carebare47/BalanceBotV2/v2/Balance-bot v2p1.stl

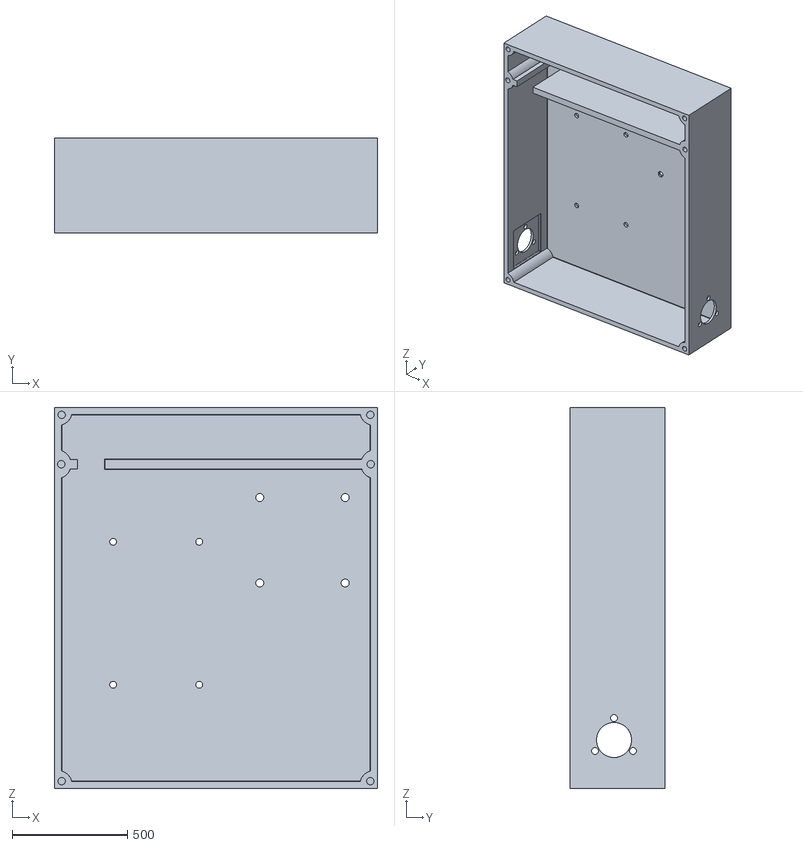
[picture p16: CAD file, 2018-06-24]
v2/Balance-bot v2p1.stl
1400.0 x 410.0 x 1650.0
