carebare47/BalanceBotV2/v2/batteryCasestl.stl

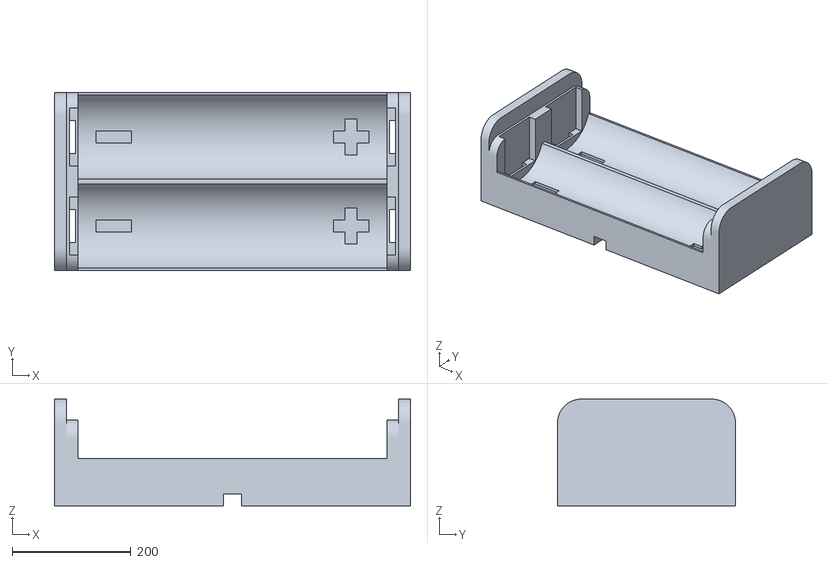
[picture p17: CAD file, 2018-06-24]
v2/batteryCasestl.stl
600.0 x 300.0 x 180.0
