carebare47/BalanceBotV2/v2/balance_bot_v2.stl

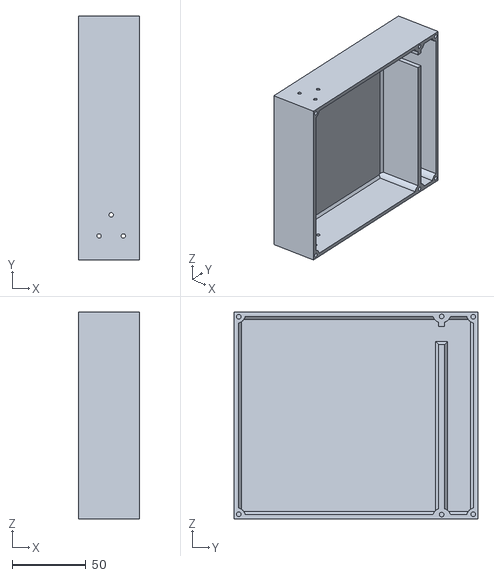
[picture p18: CAD file, 2018-06-24]
v2/balance_bot_v2.stl
41.0 x 165.0 x 140.0
