carebare47/BalanceBotV2/v2/ThinWheelMountTest.stl

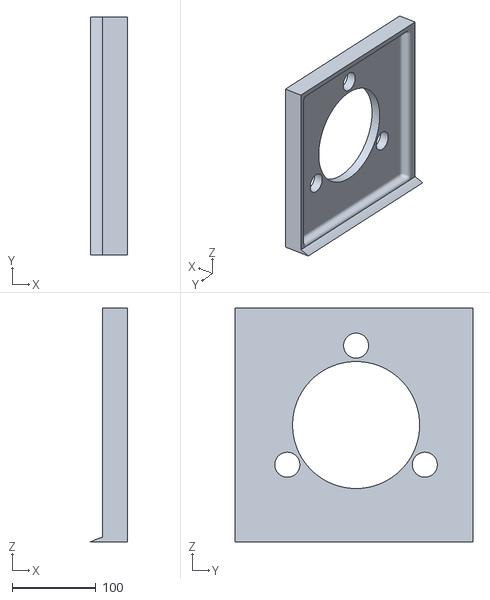
[picture p19: CAD file, 2018-06-24]
v2/ThinWheelMountTest.stl
44.7 x 285.0 x 280.0
