carebare47/BalanceBotV2/(list of files, cad)

Other CAD files:
v2/Balance-bot v7.stl
