carebare47/BalanceBotV2/(list of files, drawings)

Other design files:
v2/balance_bot_v2.pdsprj
