carebare47/BalanceBotV2/(commit log)

2018-06-08 Added a button to change activity, it crashes the app
2018-06-08 now based off LED_control
2018-06-09 Angle and position screens work, position in cm and angle in degrees & snaps back. Get IMU working next.
